asterics/FABI-addons/fabi_addon_hid/hw/stl/Hid2Fabi-Top.stl

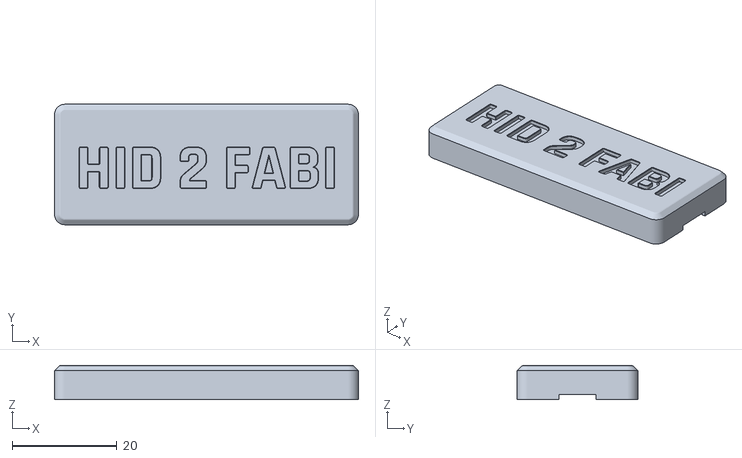
[picture p3: CAD file, 2025-11-19]
fabi_addon_hid/hw/stl/Hid2Fabi-Top.stl
58.0 x 23.0 x 6.50
