asterics/FABI-addons/fabi_addon_hid/hw/stl/Hid2Fabi-Bottom.stl

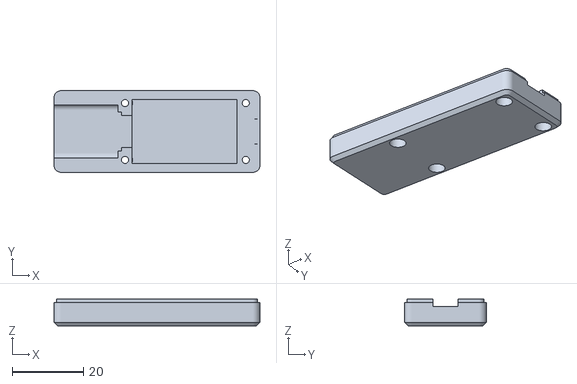
[picture p5: CAD file, 2025-11-19]
fabi_addon_hid/hw/stl/Hid2Fabi-Bottom.stl
58.0 x 23.0 x 7.50
