asterics/FABI-addons/fabi_addon_joystick/addon_joystick_case-bot_btn_16mm_hotshoe.stl

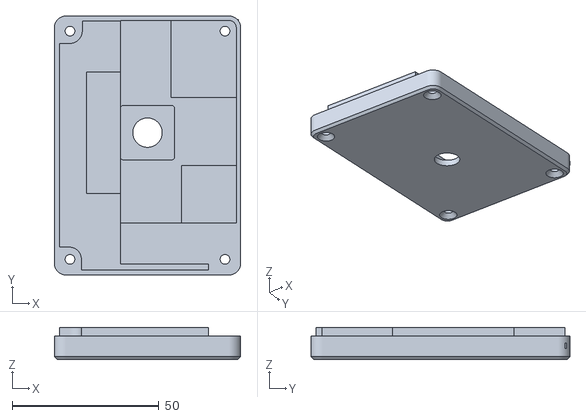
[picture p6: CAD file, 2025-11-15]
fabi_addon_joystick/addon_joystick_case-bot_btn_16mm_hotshoe.stl
63.5 x 88.2 x 11.0
