asterics/FABI-addons/fabi_addon_joystick/addon_joystick_case.FCStd

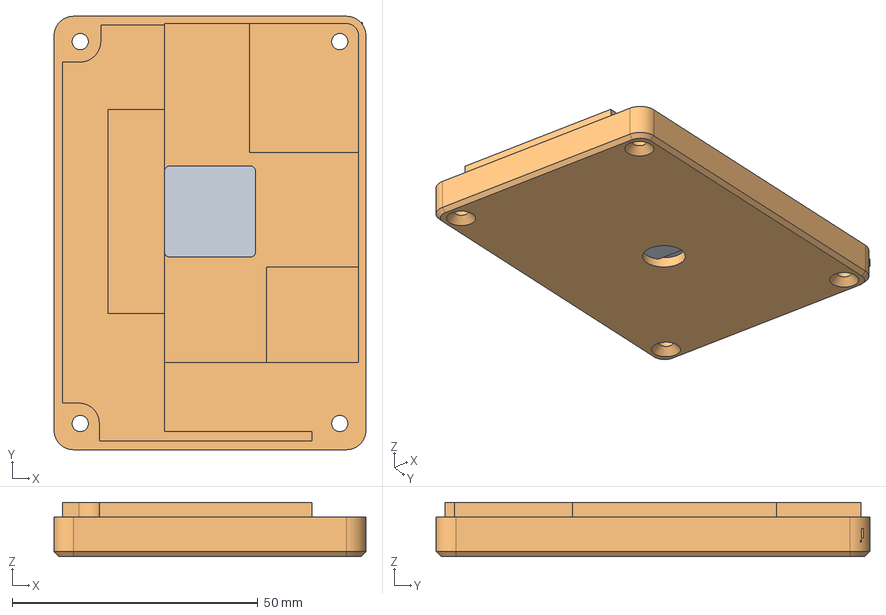
[picture p7: CAD file, 2025-11-15]
fabi_addon_joystick/addon_joystick_case.FCStd
63.5 x 88.2 x 11.0 mm
bot_btn_16mm
bot_btn_16mm_hotshoe
