asterics/FABI-addons/fabi_addon_joystick/addon_joystick_case-top_btn_16mm.stl

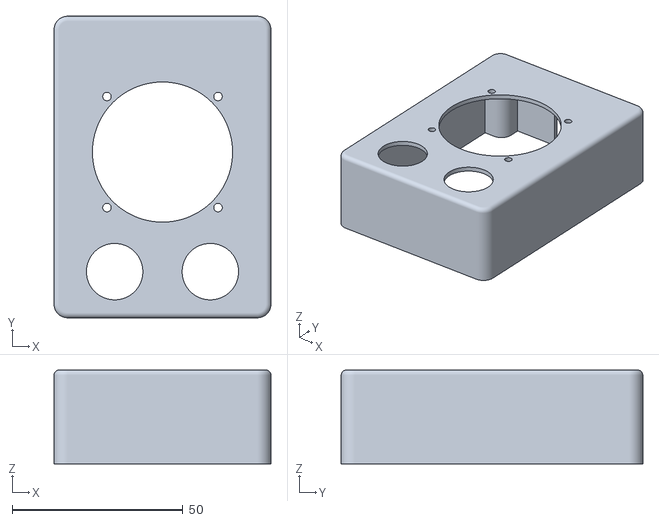
[picture p8: CAD file, 2025-11-13]
fabi_addon_joystick/addon_joystick_case-top_btn_16mm.stl
63.5 x 88.2 x 27.5
