asterics/FABI-addons/fabi_addon_joystick/addon_joystick_case-bot.stl

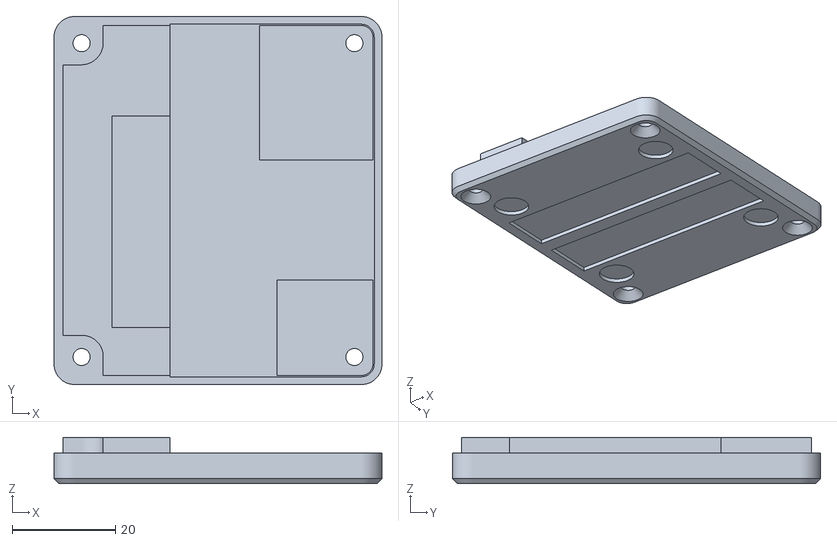
[picture p10: CAD file, 2025-04-25]
fabi_addon_joystick/addon_joystick_case-bot.stl
63.5 x 71.2 x 9.00
