asterics/FABI-addons/fabi_addon_joystick/addon_joystick_case-top_no_oled.stl

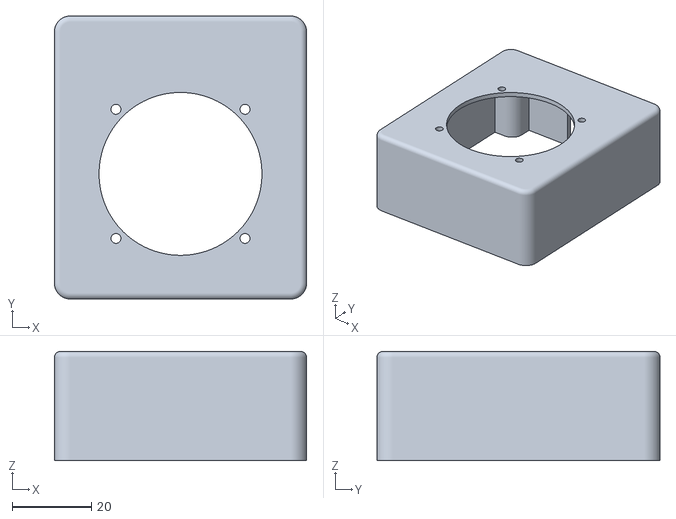
[picture p11: CAD file, 2025-04-25]
fabi_addon_joystick/addon_joystick_case-top_no_oled.stl
63.5 x 71.2 x 27.5
