asterics/FABI-addons/fabi_addon_joystick/pcb_addon_joystick.pdf

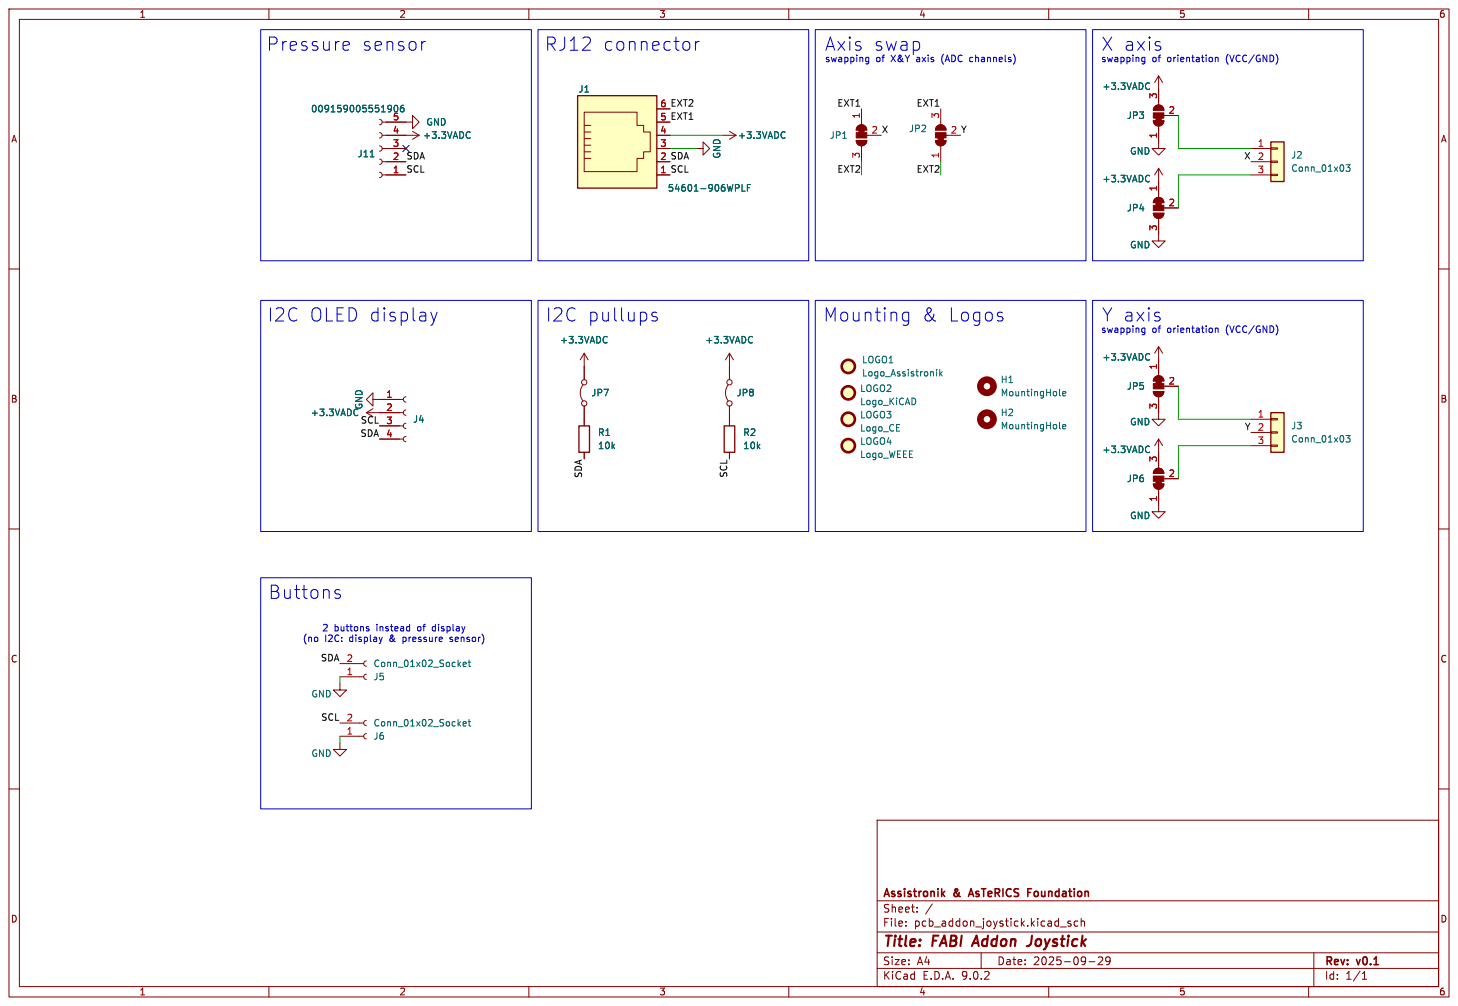
[picture p12: page 1]

swapping of X&Y axis (ADC channels)

2 buttons instead of display
(no I2C: display & pressure sensor)

Id: 1/1 Title: FABI Addon Joystick
