asterics/FABI-addons/(commit log)

2025-04-25 Initial commit of general ext connector and external joystick w/o OLED
    [addon_joystick_case-bot.stl, addon_joystick_case-top.stl, addon_joystick_case-top_no_oled.stl, addon_joystick_case.FCStd, ext_general_adapter.kicad_pcb, ext_general_adapter.kicad_sch, pcb_addon_joystick.kicad_pcb, pcb_addon_joystick.kicad_sch]
2025-09-29 SCH cleanup, added PDF plot & added 2 JST button connectors
    [pcb_addon_joystick.kicad_pcb, pcb_addon_joystick.kicad_sch]
2025-11-13 Added 16mm button case, with bottoms for table or for hotshoe mount
    [addon_joystick_case-bot_btn_16mm.stl, addon_joystick_case-bot_btn_16mm_hotshoe.stl, addon_joystick_case-top_btn_16mm.stl, addon_joystick_case.FCStd]
2025-11-15 bottom wall support for top part was not aligned
    [addon_joystick_case-bot_btn_16mm.stl, addon_joystick_case-bot_btn_16mm_hotshoe.stl, addon_joystick_case.FCStd]
2025-11-19 added stl files for enclosure
    [Hid2Fabi-Bottom.stl, Hid2Fabi-Top.stl]
2025-11-23 updated I2C protocol and FABI AddOn sensor handling
