asterics/FABI-addons/(notices)

Notices in the files:
fabi_addon_joystick/pcb_addon_joystick.kicad_pcb:
(c) 2025
